Ciumaros/Hamradio/20170505_174218.jpg

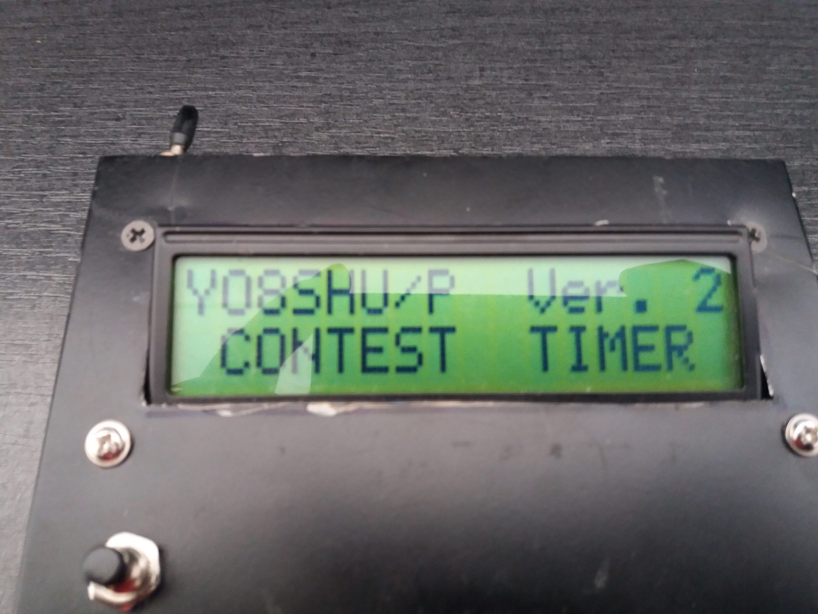
20170505_174218.jpg
