Ciumaros/Hamradio/Ceas Concurs schema.jpg

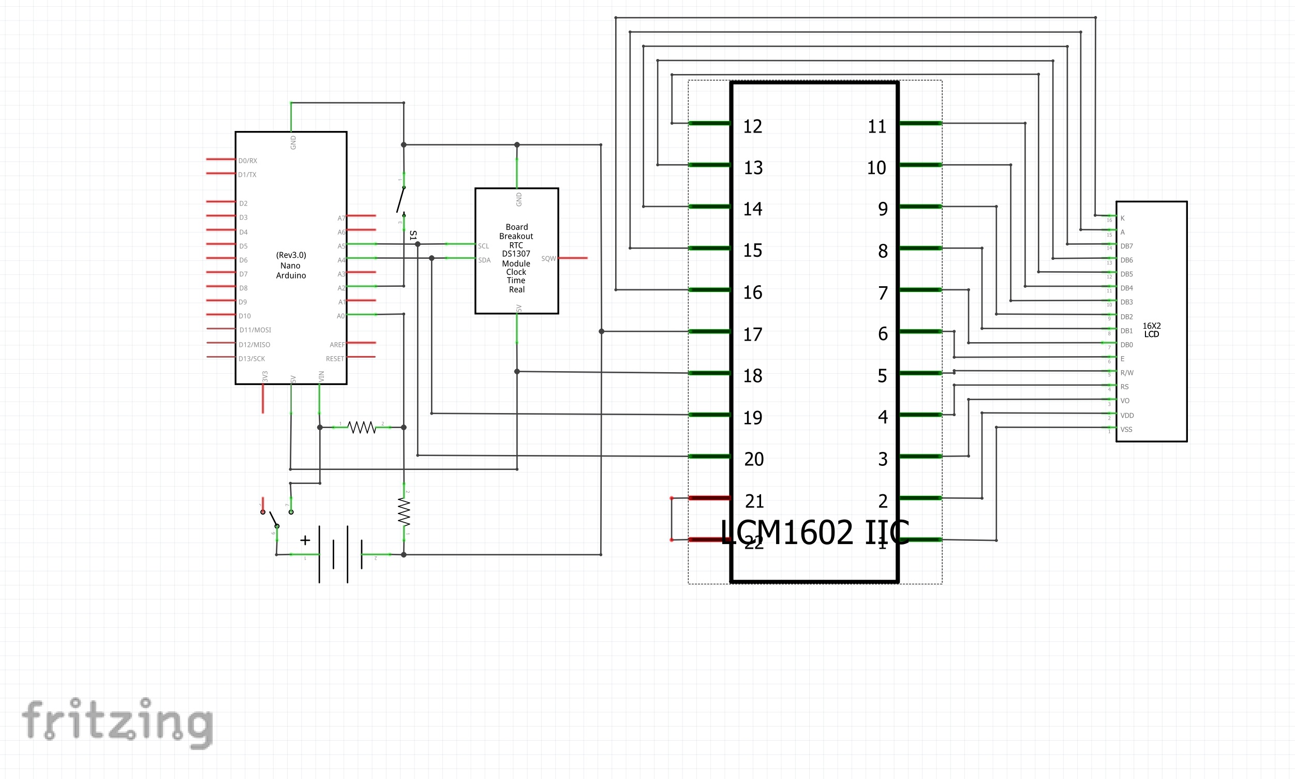
Ceas Concurs schema.jpg
